greenpig/airclock2/doc/Board_bottom.jpeg

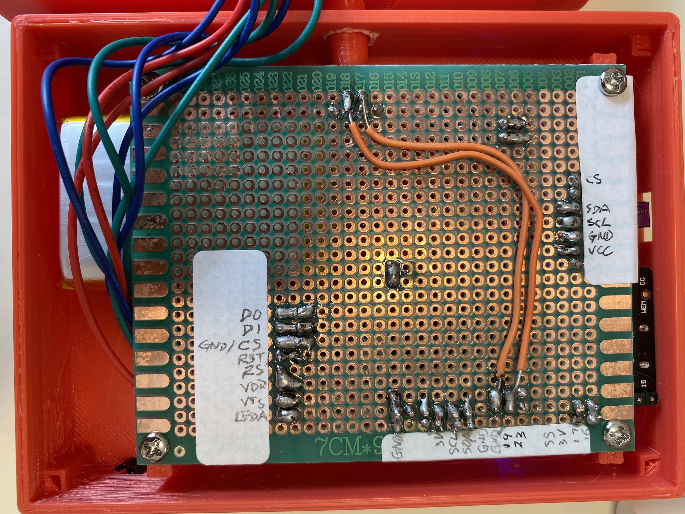
doc/Board_bottom.jpeg
