greenpig/airclock2/doc/LCD_board.jpeg

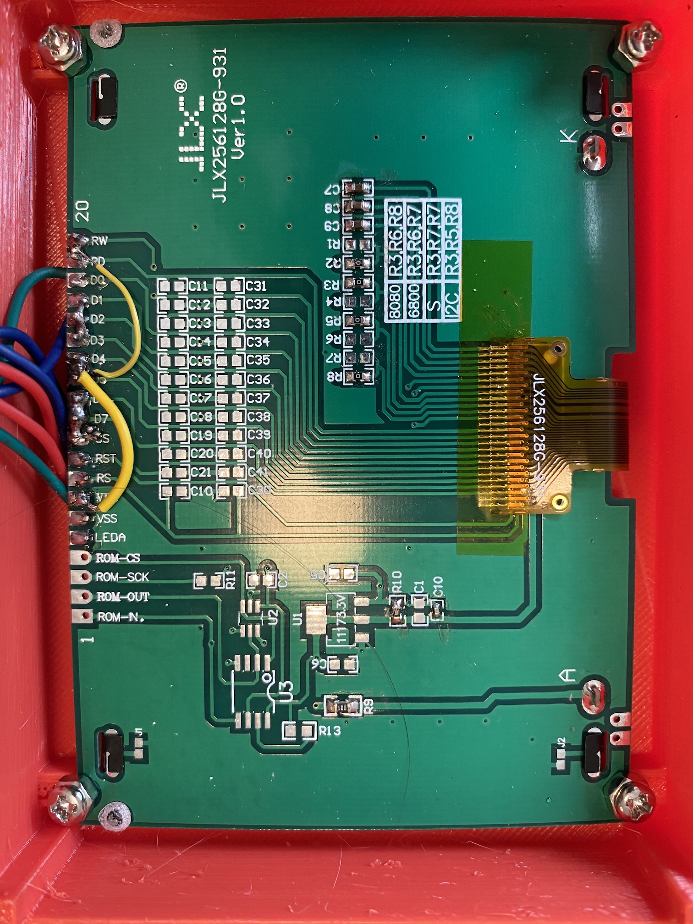
doc/LCD_board.jpeg
