greenpig/airclock2/doc/Board_up.jpeg

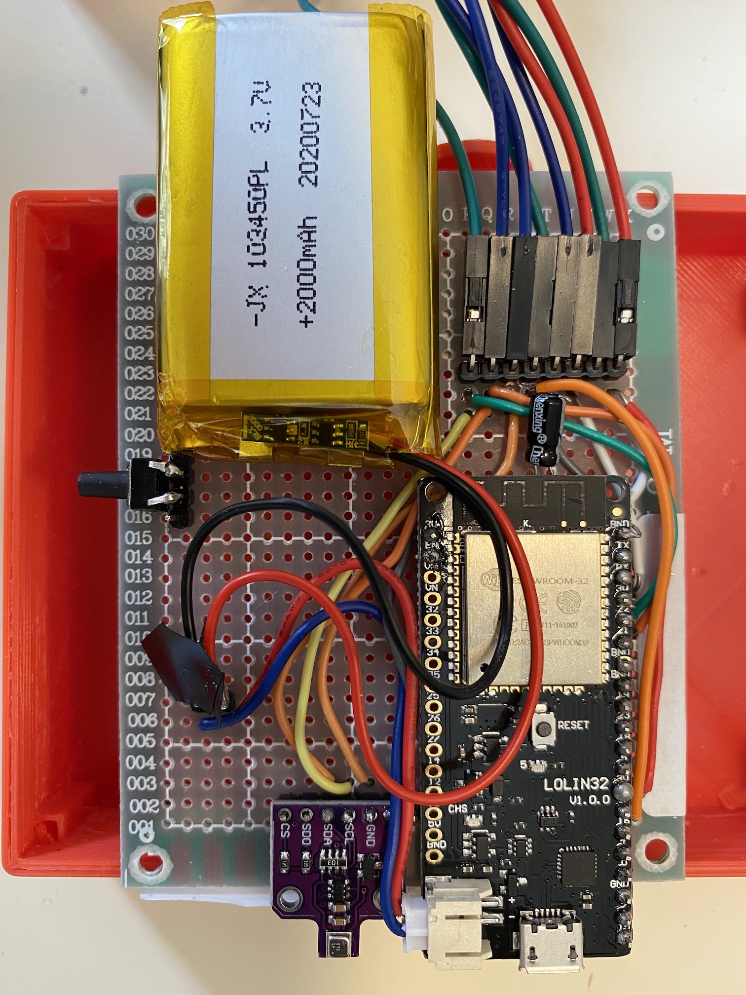
doc/Board_up.jpeg
