greenpig/airclock2/doc/Clock_screen.jpeg

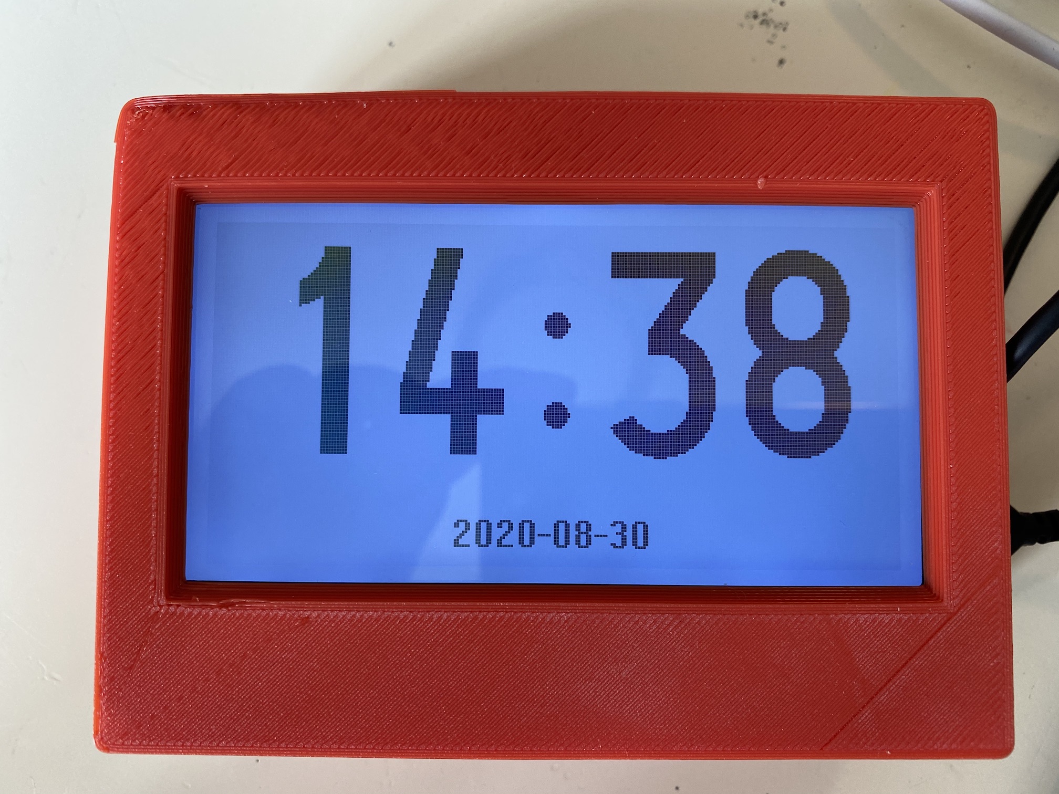
doc/Clock_screen.jpeg
