greenpig/airclock2/(commit log)

2020-08-30 AirClock 2 initial version. Clock works. Air quality sensor is not working yet.
    [airclock2.ino]
2020-08-30 Reduce power usage by refreshing LCD less
